LeonUlcakar/lab6/DAQ_REV_B (10-11-2022 10-49-59)/3dmodels/1593L PCB.stp

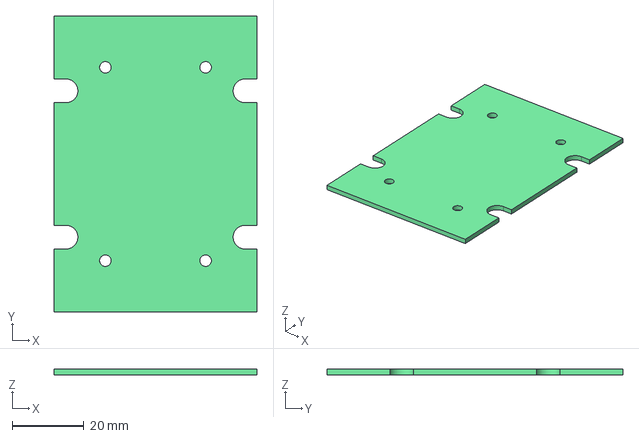
[picture p29: CAD file, 2025-11-11]
DAQ_REV_B (10-11-2022 10-49-59)/3dmodels/1593L PCB.stp
56.6 x 82.7 x 1.60 mm
