LeonUlcakar/lab6/DAQ_REV_B (10-11-2022 10-49-59)/3dmodels/1593L Top.stp

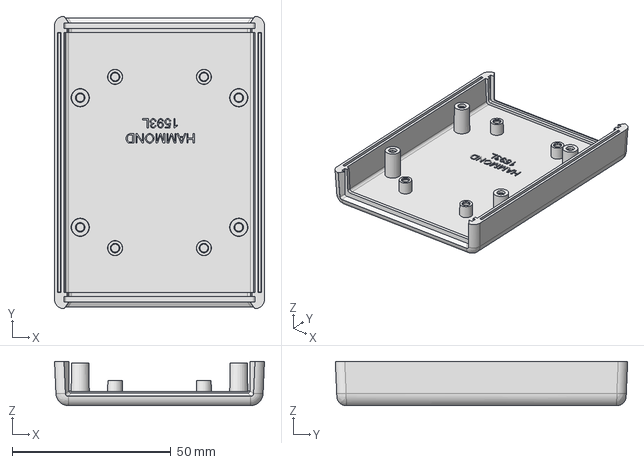
[picture p30: CAD file, 2025-11-11]
DAQ_REV_B (10-11-2022 10-49-59)/3dmodels/1593L Top.stp
66.2 x 92.2 x 14.0 mm
