LeonUlcakar/lab6/DAQ_REV_B (10-11-2022 10-49-59)/3dmodels/1593L Endplate.stp

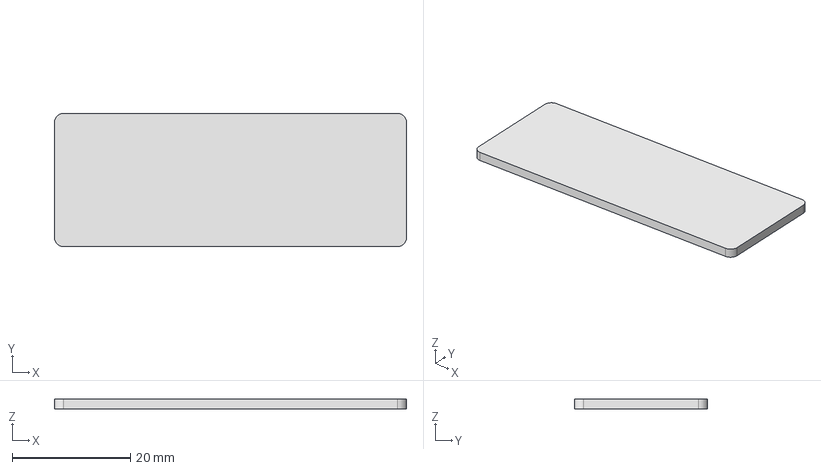
[picture p31: CAD file, 2025-11-11]
DAQ_REV_B (10-11-2022 10-49-59)/3dmodels/1593L Endplate.stp
59.5 x 22.5 x 1.70 mm
