LeonUlcakar/lab6/(list of files, drawings)

Other design files:
DAQ_REV_B (10-11-2022 10-49-59)/Cover_sheet.SchDoc
DAQ_REV_B (10-11-2022 10-49-59)/DAQ_IO.SchDoc
DAQ_REV_B (10-11-2022 10-49-59)/DAQ_REV_B.PcbDoc
DAQ_REV_B (10-11-2022 10-49-59)/DAQ_REV_B.PrjPcb
DAQ_REV_B (10-11-2022 10-49-59)/DAQ_REV_B.SchDoc
DAQ_REV_B (10-11-2022 10-49-59)/Input_amplifiers.SchDoc
DAQ_REV_B (10-11-2022 10-49-59)/Interfaces.SchDoc
DAQ_REV_B (10-11-2022 10-49-59)/Microcontroller.SchDoc
DAQ_REV_B (10-11-2022 10-49-59)/Output_amplifier.SchDoc
DAQ_REV_B (10-11-2022 10-49-59)/Power_supply.SchDoc
DAQ_REV_B (10-11-2022 10-49-59)/Reference_voltage.SchDoc
DAQ_REV_B (10-11-2022 10-49-59)/USB.SchDoc
