LeonUlcakar/lab6/(commit log)

2025-11-11 first shit
    [1593L Bottom.stp, 1593L Endplate.stp, 1593L PCB.stp, 1593L Top.stp, Cover_sheet.SchDoc, DAQ_IO.SchDoc, DAQ_REV_B.PrjPcb, DAQ_REV_B.SchDoc]
2025-11-16 fixed project tree
    [DAQ_REV_B.PrjPcb]
2025-11-19 PSU switcher added to pcbdoc
2025-11-25 added amplifiers
    [Input_amplifiers.SchDoc]
2025-12-07 wtf is going oin
    [DAQ_REV_B.PcbDoc]
2025-12-07 i am satisfied for now
    [DAQ_REV_B.PcbDoc]
2025-12-07 initila commit
    [DAQ_REV_B.PcbDoc]
2025-12-07 ngl, quite satisfied
    [DAQ_REV_B.PcbDoc]
2025-12-08 kill me rework
    [DAQ_REV_B.PcbDoc]
2025-12-08 after common mistakes
    [DAQ_REV_B.PcbDoc]
2025-12-09 added via stiching
    [DAQ_REV_B.PcbDoc]
2025-12-09 added via stiching (igram se)
    [DAQ_REV_B.PcbDoc]
2025-12-10 days never finished
    [DAQ_REV_B.PcbDoc]
2025-12-16 fixed agnd gnd connection and stiching
    [DAQ_REV_B.PcbDoc]
2025-12-16 MORE BEAUTY
    [DAQ_REV_B.PcbDoc]
2025-12-17 moved switcher up a bit, i don't like it
    [DAQ_REV_B.PcbDoc]
2025-12-17 smh ok, changed aps en routing
    [DAQ_REV_B.PcbDoc]
2025-12-17 small fixamjig
    [DAQ_REV_B.PcbDoc]
2025-12-21 bit of a rework, my god look at the time
    [DAQ_REV_B.PcbDoc]
2025-12-21 just a bit more
    [DAQ_REV_B.PcbDoc]
2025-12-22 added low impedance shielding
    [DAQ_REV_B.PcbDoc]
2025-12-23 pretty much ready for deployment. do not add teardrops
    [DAQ_REV_B.PcbDoc]
2025-12-25 fixed critical bypass connection
    [DAQ_REV_B.PcbDoc]
2025-12-25 final alteration
    [DAQ_REV_B.PcbDoc]
2025-12-28 last min fixes
    [DAQ_REV_B.PcbDoc]
2025-12-28 let's say io'm satisfied again
    [DAQ_REV_B.PcbDoc]
